MadduxMadayag/twinsix-macropad/images/enclosure-plate.png

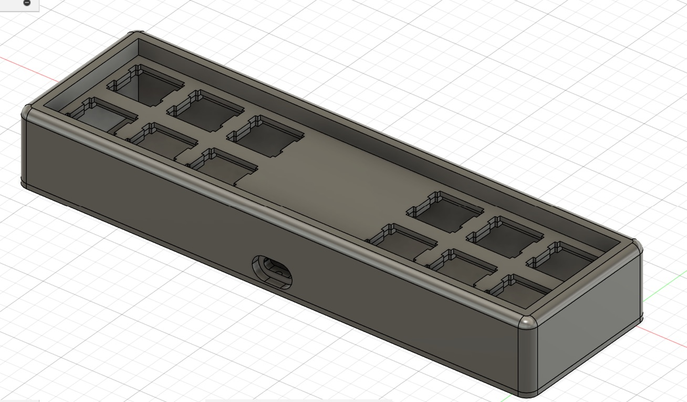
images/enclosure-plate.png
