MadduxMadayag/twinsix-macropad/mechanical/bottomlasercut.dxf

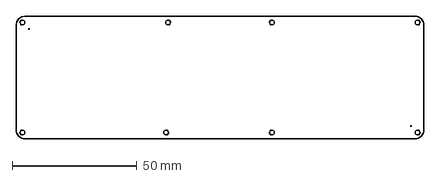
[picture p8: CAD file, 2026-10-09]
mechanical/bottomlasercut.dxf
163.4 x 49.1 mm
