MadduxMadayag/twinsix-macropad/mechanical/top.stl

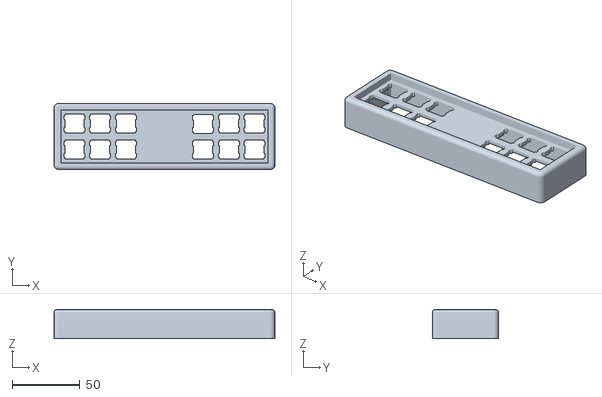
[picture p9: CAD file, 2026-10-09]
mechanical/top.stl
163.4 x 49.1 x 21.5
