MadduxMadayag/twinsix-macropad/mechanical/bottom.stl

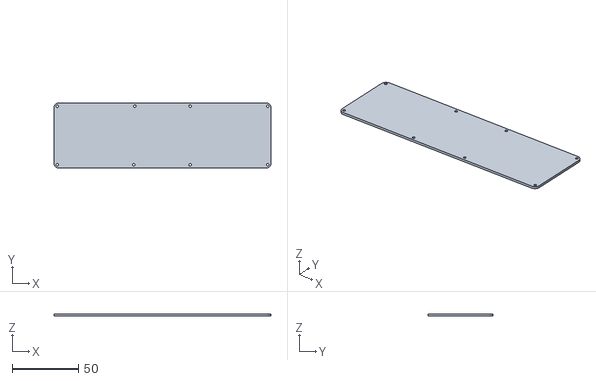
[picture p10: CAD file, 2026-10-09]
mechanical/bottom.stl
163.4 x 49.1 x 1.59
