MadduxMadayag/twinsix-macropad/hardware/kicad/twinsix-design.kicad_pcb

## KiCad design hardware/kicad/twinsix-design.kicad_pcb (2026-10-09)

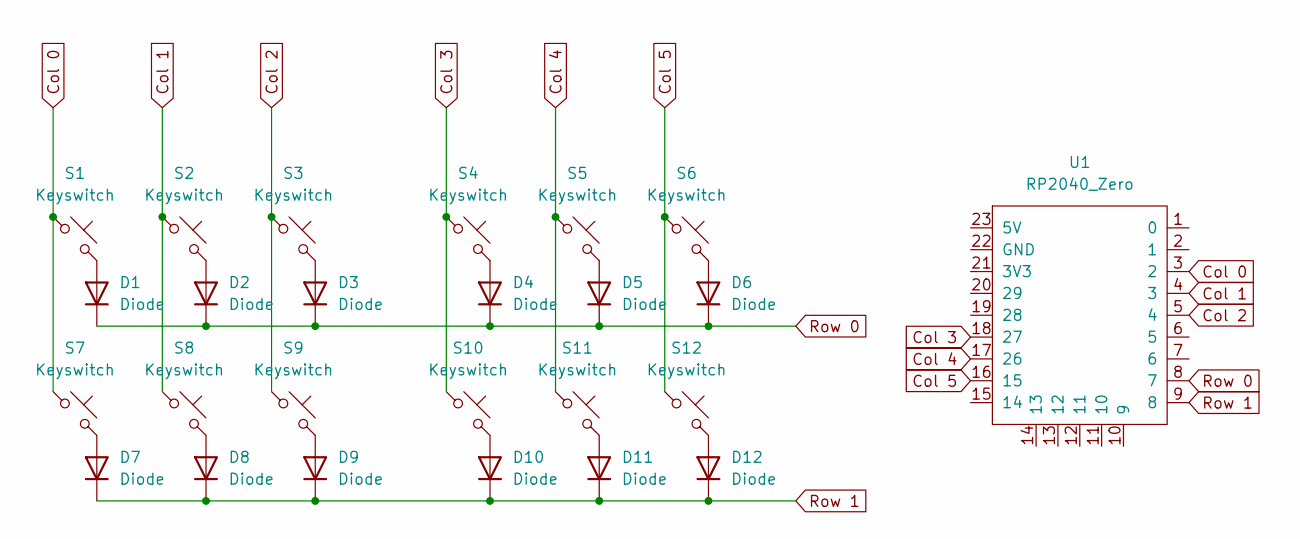
[picture p11: schematic twinsix-design.kicad_sch]

Parts:
D1, D2, D3, D4, D5, D6, D7, D8, D9, D10, D11, D12: Diode; Diode_DO-35
S1, S2, S3, S4, S5, S6, S7, S8, S9, S10, S11, S12: Keyswitch; MX_PCB_1.00u
U1: RP2040_Zero

Connections:
Col 0: S1.1, S7.1, U1.3 (2)
Col 1: S2.1, S8.1, U1.4 (3)
Col 2: S3.1, S9.1, U1.5 (4)
Col 3: S4.1, S10.1, U1.18 (27)
Col 4: S5.1, S11.1, U1.17 (26)
Col 5: S6.1, S12.1, U1.16 (15)
unnamed: D1.2 (A), S1.2
unnamed: D2.2 (A), S2.2
unnamed: D3.2 (A), S3.2
unnamed: D4.2 (A), S4.2
unnamed: D5.2 (A), S5.2
unnamed: D6.2 (A), S6.2
unnamed: D7.2 (A), S7.2
unnamed: D8.2 (A), S8.2
unnamed: D9.2 (A), S9.2
unnamed: D10.2 (A), S10.2
unnamed: D11.2 (A), S11.2
unnamed: D12.2 (A), S12.2
Row 0: D1.1 (K), D2.1 (K), D3.1 (K), D4.1 (K), D5.1 (K), D6.1 (K), U1.8 (7)
Row 1: D7.1 (K), D8.1 (K), D9.1 (K), D10.1 (K), D11.1 (K), D12.1 (K), U1.9 (8)

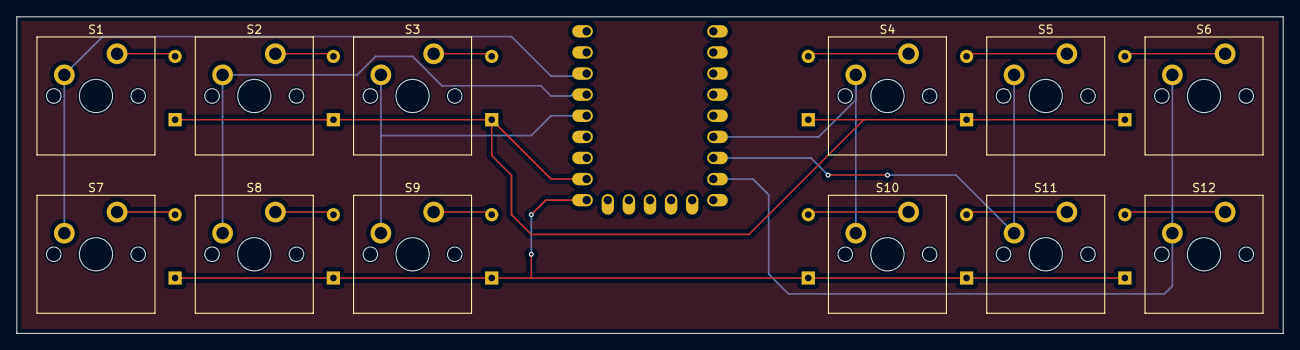
[picture p12: board twinsix-design.kicad_pcb from above]

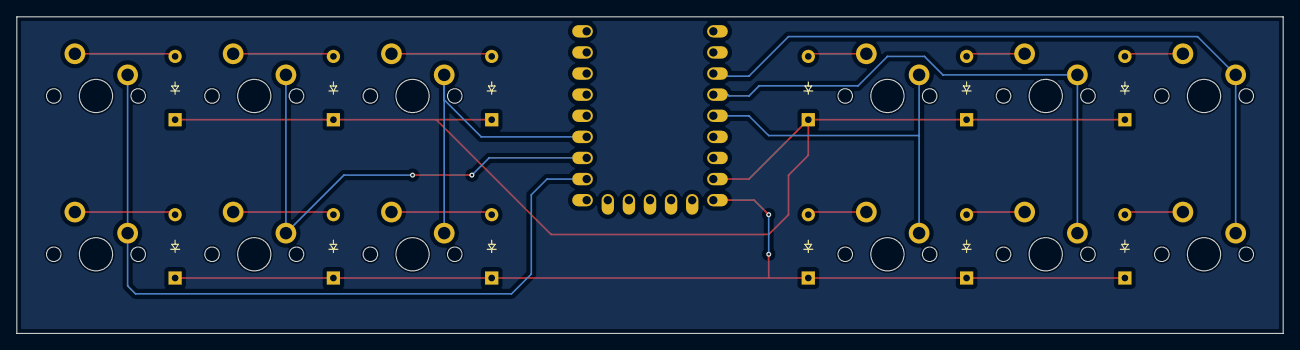
[picture p13: board twinsix-design.kicad_pcb from below]

Board: 2 copper layers, 152.4 x 38.1 mm, 25 parts (13 on the bottom side), 20 nets.
